vova-tymosh/RCC-Nodes/README.md

# RCC-Nodes

This is the home for various applications of the RCC technology - decoders, throttle and other things. Read more about RCC on the main page - [RCC](https://github.com/vova-tymosh/RCC).

Content is organized in the following folders:
* [Loco](Loco): how to build and use RCC locomotive decoder
* [Throttle](Throttle): how to build and use a handheld RCC controller/throttle (_coming soon_)
* Turnout: _coming soon_
* Test: the set of tests for the RCC components (this folder might be of interest only for the contributors).
