vova-tymosh/RCC-Nodes/Loco/schematic/info.txt

Change log:
    v0.8: Add resistor for LED
    v0.7: Change MAX
    v0.6: Add LED
    v0.5: Add sound, bemf.
          Remove bulk, add GPIOs 
    v0.3: Add bulk capacitor
    v0.2: Fix i2c
    v0.1: Very initial build

Schematic details and considerations:

Capacitors:
    ina219, XIAO, ULN: no caps
    LDO: 1uF on both sides
    DRV: 1+100uF
    MAX: 10+0.1uF
    TCA: Likely 1uF

Voltage rating:
    LDO: 24V
    DRV: 45v
    ULN: 50v
    ina: 26v

I2C Addresses:
    INA: 0x40
    TCA: 0x21 (addr pin is connected to VCC, so the address is 0x21, not 0x20)
