vova-tymosh/RCC-Nodes/Loco/image/decoder_front.png

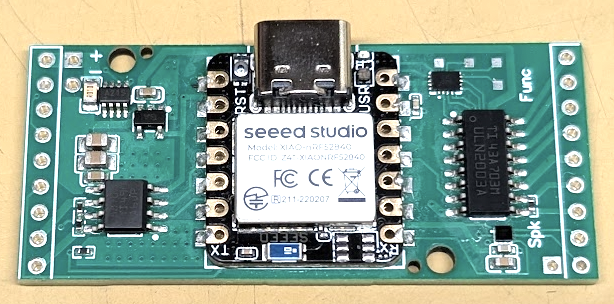
Loco/image/decoder_front.png
