vova-tymosh/RCC-Nodes/Loco/fabrication/BOM_RccDecoder.csv

ID | Name | Designator | Footprint | Quantity | Manufacturer Part | Manufacturer | Supplier | Supplier Part | Price
1 | JFunc | J2 | CONN-9P-SMALL | 1 | KF128-2.54-9P | KEFA(科发) | LCSC | C474927 | 0.921
2 | JMain | J1 | CONN-9P-SMALL | 1 | KF128-2.54-9P | KEFA(科发) | LCSC | C474927 | 0.921
3 | 22uF | C5,C3 | C0805 | 2 | CL21A226MAQNNNE | SAMSUNG(三星) | LCSC | C45783 | 0.021
4 | 1uF | C1,C4 | C0603 | 2 | CL10A105KB8NNNC | SAMSUNG(三星) | LCSC | C15849 | 0.004
5 | 2.2uF | C2 | C0402 | 1 | CL05A225MQ5NSNC | SAMSUNG(三星) | LCSC | C12530 | 0.002
6 | 10uF | C6 | C0402 | 1 | CL05A106MQ5NUNC | SAMSUNG(三星) | LCSC | C15525 | 0.004
7 | 220nF | C7 | C0603 | 1 | CL10B224KA8NNNC | SAMSUNG(三星) | LCSC | C21120 | 0.005
8 | 10mΩ | R1 | R0805 | 1 | RLM10FTBMR010 | 大毅科技 | LCSC | C382280 | 0.049
9 | 4.7kΩ | R2,R4,R5 | R0402 | 3 | 0402WGF4701TCE | UNI-ROYAL(厚声) | LCSC | C25900 | 0.001
10 | 1kΩ | R3 | R0402 | 1 | 0402WGF1001TCE | UNI-ROYAL(厚声) | LCSC | C11702 | 0.001
11 | AP2204K-5.0TRG1(MS) | U2 | SOT-23-5_L3.0-W1.5-P0.95-LS2.8-BL | 1 | AP2204K-5.0TRG1(MS) | MSKSEMI(美森科) | LCSC | C20627186 | 0.111
12 | DRV8870DDAR | U3 | HSOP-8_L5.0-W4.0-P1.27-LS6.2-BL-EP | 1 | DRV8870DDAR | TI(德州仪器) | LCSC | C86590 | 0.28
13 | INA219AIDCNR | U4 | SOT-23-8_L3.0-W1.7-P0.65-LS2.8-BR | 1 | INA219AIDCNR | TI(德州仪器) | LCSC | C87469 | 0.594
14 | TCA6408ARSVR | U5 | UQFN-16_L2.6-W1.8-P0.40-BL | 1 | TCA6408ARSVR | TI(德州仪器) | LCSC | C2649390 | 0.467
15 | ULN2003ADR | U6 | SOIC-16_L9.9-W3.9-P1.27-LS6.0-BL | 1 | ULN2003ADR | TI(德州仪器) | LCSC | C7512 | 0.098
16 | MAX98357AEWL+T | U7 | WLP-9_L1.4-W1.3-P0.40-R3-C3-BR | 1 | MAX98357AEWL+T | ADI(亚德诺)/MAXIM(美信) | LCSC | C2682619 | 0.485
