vova-tymosh/RCC-Nodes/Loco/schematic/Schematic_RccDecoder_v05.pdf

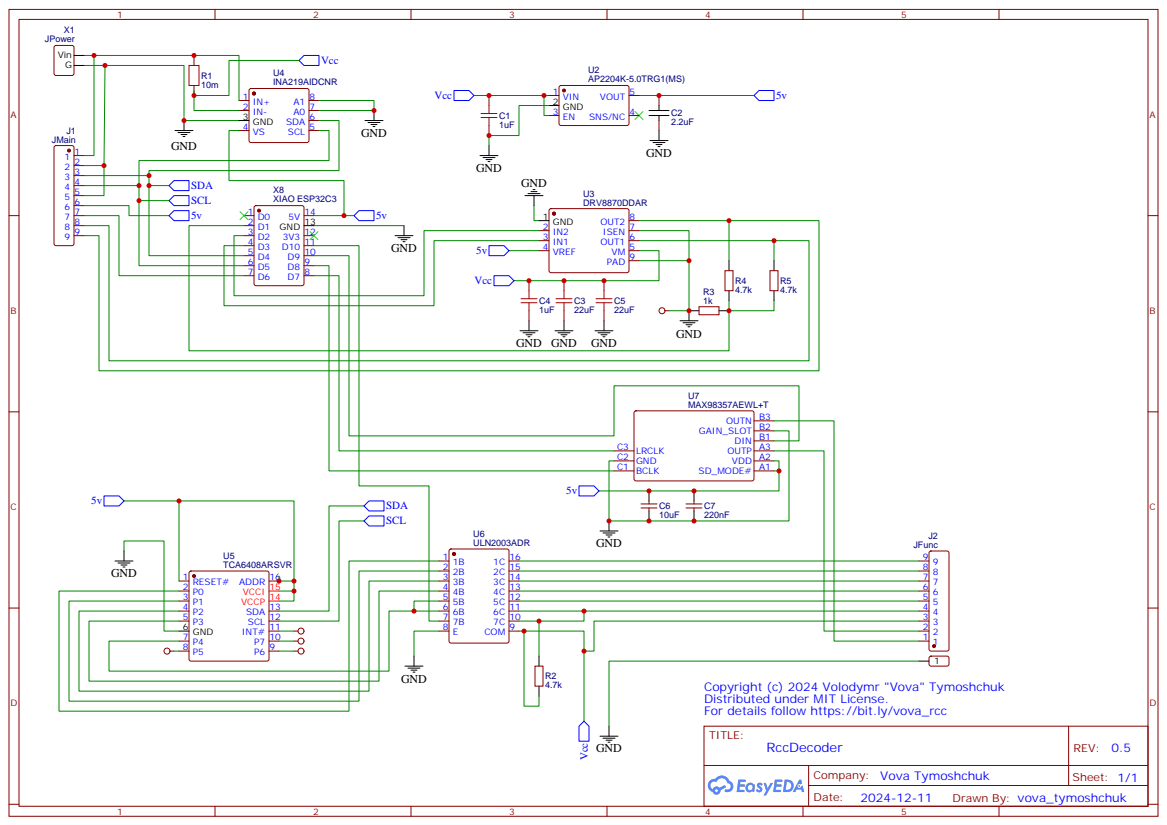
[picture p6: page 1]

TCA6408ARSVR
P7 10 INT# 11 SCL 12 SDA 13 VCCP 14 VCCI 15 ADDR 16

Copyright (c) 2024 Volodymr "Vova" Tymoshchuk
Distributed under MIT License.
For details follow https://bit.ly/vova_rcc
TITLE:
