vova-tymosh/RCC-Nodes/(threads)

Thread 1 (2024-12-05):

Before hw v0.4

vova-tymosh, 2024-12-05:
- [x] 1. Test drv at 1, 2, 3A. Check temperature
- [x] 2. Try 4A and see what will happen
- [x] 3. Test 300-400mA load on 5v
- [x] 4. Run 212 w/o bulk capacitor.
- [x] 5. Including motor stall
- [x] 6. Try 1,2A load with bulk (if it helps)
- [x] 7. If no issues - remove bulk from 0.4

Closed 2025-01-10.

Thread 3 (2025-01-10):

Build test bed

vova-tymosh, 2025-01-10:
- [ ] Build pogo setup
- [ ] Add all HW around pogo
- [ ] Write self-sustaining fully automated test - sanity/smoke test.
- [ ] Add FW flashing
- [ ] Deeper test, semi-auto with LED for motor and things
