vova-tymosh/RCC-Nodes/Throttle/HomeScreen.h

#pragma once

#include "Battery.h"
#include "LocoState.h"
#include "States.h"
#include "Rotary.h"
#include "Timer.h"
#include "UI.h"


extern UserInterface ui;

class HomeScreen : public BaseState
{
    int oldThrottle = 0;
    int rotaryOffset = 0;

private:
    Timer batteryCycle;
    Timer throttleCycle;


    char renderDirection()
    {
        if (pad.state.direction == 0)
            return 'R';
        if (pad.state.direction == 2)
            return '\xEF';
        else
            return 'F';
    }

    void renderBattery()
    {
        static int animation;
        int level = battery.getLevel();
        if (battery.isCharging()) {
            if (batteryCycle.hasFired()) {
                if (animation >= UserInterface::BATTERY_FULL)
                    animation = 0;
                else
                    animation++;
            }
            level = animation;
        }
        ui.showBattery((UserInterface::BatteryState)level);
    }

    void renderDisatnce(char *line, int distance)
    {
        if (distance < 1000) {
            sprintf(line, "%-3d          ", distance);
        } else if (distance < 10000) {
            sprintf(line, "%.2fk         ", (float)distance / 1000);
        } else {
            sprintf(line, "%.1fk         ", (float)distance / 1000);
        }
    }

    void renderTime(char *line)
    {
        unsigned long now = millis();
        now = now - controls.timerBase;
        unsigned long sec = now / 1000;
        unsigned long min = sec / 60;
        sec = sec % 60;
        sprintf(line, "%02d:%02d", min, sec);
    }

    void renderSmall()
    {
        static const char fmt1[] = "Loco:%4s   %3d%%";
        static const char fmt2[] = "T:%-3d R:%-3d S:%-3d D:%c";
        static const char fmt3[] = "%2d%cC    %2dpsi    ";
        static const char fmt4[] = "ODO:                     ";
        char line[ui.width + 1];

        ui.startScreen();
        sprintf(line, fmt1, pad.getSelectedName(), pad.getConnSuccessRate());
        ui.display.println(line);
        sprintf(line, fmt2, controls.throttle, pad.state.throttle, pad.state.speed, renderDirection());
        ui.display.println(line);
        sprintf(line, fmt3, pad.state.temperature, 0xF7, pad.state.psi);
        ui.display.println(line);
        sprintf(line, fmt4);
        renderDisatnce(line + 4, pad.state.distance);
        renderTime(line + 16);
        ui.display.println(line);

        renderBattery();
        ui.display.display();
    }

    void renderBig()
    {
        static const char fmt1[] = "T:%-3d %c%c";
        static const char fmt2[] = "%2d%c %.1fk";
        char line[ui.width + 1];

        ui.startScreen();
        ui.display.setTextSize(2);
        char alive = ' ';//comms.isAlive() ? 0x1F : ' ';
        sprintf(line, fmt1, controls.throttle, renderDirection(), alive);
        ui.display.println(line);
        sprintf(line, fmt2, pad.state.temperature, 0xF7,
                (float)pad.state.distance / 1000);
        ui.display.println(line);

        renderBattery();
        ui.display.setTextSize(1);
        ui.display.display();
    }

public:
    HomeScreen() : batteryCycle(500), throttleCycle(300) {};


    int getRotary()
    {
        int r = rotary.readAccelerated();
        int t = 2 * (r - rotaryOffset);
        if (t > 100) {
            t = 100;
            rotaryOffset = r - t/2;
        } else if (t <= 0) {
            t = 0;
            rotaryOffset = r;
        }
        return t;
    }

    State handle(char key)
    {
        if (key == 'm') {
            return STATE_MENU;
        } else if (key == 's') {
            controls.throttle = 0;
            rotaryOffset = rotary.read();
        } else if (key == ON_ENTER) {
            controls.throttle = pad.state.throttle;
            rotaryOffset = rotary.read() - controls.throttle / 2;
            batteryCycle.start();
            throttleCycle.start();
        } else if (key == 'd') {
            if (controls.direction != 0)
                controls.direction = 0;
            else
                controls.direction = 1;
            pad.setDirection(controls.direction);
            pad.askHeartbeat();
        }

        controls.throttle = getRotary();
        if ((pad.state.throttle != controls.throttle) && throttleCycle.hasFired()) {
            pad.setThrottle(controls.throttle);
            pad.askHeartbeat();
        }

        if (settings.getCachedInt("BigFont"))
            renderBig();
        else
            renderSmall();

        return STATE_NONE;
    }
};
