vova-tymosh/RCC-Nodes/Throttle/MenuScreen.h

#pragma once

#include "States.h"
#include "Storage.h"
#include "UI.h"
#include "Rotary.h"


extern UserInterface ui;
extern Storage storage;

class MenuItem
{
protected:
    const char *name;
    const int index;

public:
    MenuItem(const char *name, const int index) : name(name), index(index) {}
    virtual void setup() {};
    virtual void render(char *line, size_t size) = 0;
    virtual void toggle() = 0;
};

class MenuItemLocoName : public MenuItem
{
public:
    MenuItemLocoName() : MenuItem(NULL, 0) {}

    void render(char *line, size_t size)
    {
        static const char fmt1[] = "Loco             %-4s";
        snprintf(line, size, fmt1, pad.getSelectedName());
    }

    void toggle()
    {
        pad.cycleSelected();
        pad.askHeartbeat();
        pad.getValue("pump");
    }
};

class MenuItemFunction : public MenuItem
{
public:
    MenuItemFunction(const char *name, const int index)
        : MenuItem(name, index) {}

    void render(char *line, size_t size)
    {
        static const char fmt1[] = "%-18s%s";
        if (pad.state.bitstate & (1 << index))
            snprintf(line, size, fmt1, name, "ON");
        else
            snprintf(line, size, fmt1, name, "OFF");
    }

    void toggle()
    {
        int state = (pad.state.bitstate & (1 << index)) ? 0 : 1;
        pad.setFunction(index, state);
        pad.askHeartbeat();
    }
};

class MenuItemPump : public MenuItem
{
public:
    MenuItemPump() : MenuItem("pump", 0) {}

    void render(char *line, size_t size)
    {
        snprintf(line, size, "Pump              %d", controls.pump);
    }

    void toggle()
    {
        if (controls.pump < 100)
            controls.pump += 10;
        else
            controls.pump = 0;
        pad.setValue("pump", String(controls.pump).c_str());
    }
};


class MenuItemSetting : public MenuItem
{
    int savedState;

public:
    MenuItemSetting(const char *name)
        : MenuItem(name, 0)
    {
    }

    void render(char *line, size_t size)
    {
        static const char fmt1[] = "%-18s%s";
        if (settings.getCachedInt(name))
            snprintf(line, size, fmt1, name, "ON");
        else
            snprintf(line, size, fmt1, name, "OFF");
    }

    void toggle()
    {
        int c = settings.getCachedInt(name);
        settings.put(name, String(c ? 0 : 1));
    }
};

class MenuItemLocal : public MenuItem
{
    int saved;
    const char* settingName = "locoaddr";
    const int node = 1;

public:
    MenuItemLocal()
        : MenuItem("", 0) {}

    void setup()
    {
        saved = settings.getCachedInt(settingName);
    }

    void render(char *line, size_t size)
    {
        int c = settings.getCachedInt(settingName);
        if (c != saved)
            snprintf(line, size, "Local(bootme)     %s", c ? "OFF" : "ON");
        else
            snprintf(line, size, "Local             %s", c ? "OFF" : "ON");
    }

    void toggle()
    {
        int c = settings.getCachedInt(settingName);
        settings.put(settingName, String(c ? 0 : node));
    }
};



auto mi0 = MenuItemLocoName();
auto mi1 = MenuItemFunction("Lights", 0);
auto mi2 = MenuItemFunction("Bell", 1);
auto mi3 = MenuItemFunction("Slow", 28);
auto mi4 = MenuItemFunction("Pid", 29);
auto mi5 = MenuItemPump();
auto mi6 = MenuItemSetting("BigFont");
auto mi7 = MenuItemLocal();
MenuItem *menuItem[] = {&mi0, &mi1, &mi2, &mi3, &mi4, &mi5, &mi6, &mi7};

class MenuScreen : public BaseState
{
    static const int LINES = 4;
    static const int menuSize = sizeof(menuItem) / sizeof(menuItem[0]);
    int selected = 0;
    int rotaryOffset = 0;
public:
    void setup()
    {
        for (int i = 0; i < sizeof(menuItem) / sizeof(menuItem[0]); i++)
            menuItem[i]->setup();
    }

    State handle(char key)
    {
        if (key == 'h') {
            return STATE_HOME;
        } else if (key == ON_ENTER) {
            pad.getValue("pump");
            selected = 0;
            rotaryOffset = rotary.read();
        } else if (key == 'm') {
            menuItem[selected]->toggle();
        }

        selected = (rotaryOffset - rotary.read()) % menuSize;
        if (selected < 0)
            selected = menuSize + selected;
        else if (selected >= menuSize)
            selected = menuSize - 1;

        int base = 0;
        if (selected >= LINES)
            base = selected - LINES + 1;
        ui.startScreen();
        for (int i = base; i < base + LINES; i++) {
            char line[ui.width + 1];
            ui.textColor(selected == i);
            menuItem[i]->render(line, sizeof(line));
            ui.display.println(line);
        }
        ui.display.display();
        return STATE_NONE;
    }
};
