vova-tymosh/RCC-Nodes/(commit log)

2024-04-17 New protocol for Throttle support
    - Rename Controller to Throttle (as per JMRI standard)
    - Define new Auth for Loco/Thr
    - Add todos for Throttle code
    - Throttle auth/subsription still missing list of locos
    [HomeScreen.h, LocoState.h, MenuScreen.h, Rotary.h, Throttle.ino, UI.h]
2024-04-28 Throttle <> Loco comunication
    - Change protocol to fixed for all Locos
    - Move light to functions
    - Make functions start with lights and with code '@'
    - Store all the functions as bitstate
    - Update RRLib test to emmit all new fields
    - Chnage Loco status messages to send u16 instead of floats
    - Forward data from Throttle to Loco via push
    - Remove slow forwarding (for now)
    - Handle battery presentation (1-3 from %%)
    - Handle lights in menu and throttle by the rotary
    - Add retries to the send function on Throttle side
    [HomeScreen.h, LocoState.h, MenuScreen.h, Rotary.h, Throttle.ino]
2024-04-30 Further improvements
    - Change direction to 2 bits
    - Change direction to 0,1,2 instead of 0,1,-1
    - Handle stop on RRlib side
    - Mimic speed with Slow and Stop
    - Use received state for Menu items
    - Queue up Thr messages and resend couple times
    - Add inbound/outbound lost (temporarily)
2024-04-30 Conn improvements
    - Reduce Station power to LOW
    - Remove all Thr queue code, just resend last command every 100ms
2024-05-01 Screensaver and small fixes
    - Add Screen Svaer (turn off screen after timeout)
    - Replace loco to extern for HomeScreen
    - Restructure Lost for ThrComms
    - Add Thr lost to Loco lost on Home screen
    [HomeScreen.h, LocoState.h, MenuScreen.h, Throttle.ino, UI.h]
2024-05-01 Proper states and scrolling in menu
    - Replace ugle state functions with nice objects
    - Add more than 4 items in menu with scrolling
    [HomeScreen.h, MenuScreen.h, States.h, Throttle.ino]
2024-05-01 Fix rotary & other minor things
    - Move Rotary to another input (the board needs to be replaced)
    - Add water field
    - Add T/R on Home
    - Minor fixes
    [HomeScreen.h, LocoState.h, Rotary.h, Throttle.ino]
2024-05-01 Fixes in lost calculation
    [HomeScreen.h]
2024-05-01 Add Thr battery
    - Read voltage & charging
    - Show level & charging process
2024-05-01 Add Loco battery as "B:", rearrange Home
2024-05-05 Local mode
    - Send all new reg to Thr when new Loco registers
    - Add Settings (starting with local mode)
    - Add FS to save/restore Settings
    - Menu item for Local
    - Fix cycling through locos in both Local/Remote modes
    - ThrComm support for Local
    [LocoState.h, MenuScreen.h, Throttle.ino]
2024-05-14 Updated 948 to the new wireless protocol and couple fixes
    - Remove outdated code
    - Move motor control to seperate file
    - Spinn off Led to a RRlib class
    - Push Storage into a class, handle save/restore inside Comms
    - Add constrain to Comms throttle and direction
    - Reaplce Speed Sensor with 1204 implementation
    - Update Thr keypad per the latest schematic
    [Rotary.h, Throttle.ino]
2024-05-15 Fixes
    - Restore watchdog for 948
    - Fix 'd' key (should do 'stop' only on Home)
    - Fix Thr screensaver
    [HomeScreen.h, Throttle.ino]
2024-06-06 Throttle updates - LocoState and Rotary period
    - Share LocoState strcut between Loco and Throttle
    - Update Rotary more often to smooth live steam servo
2024-06-11 Set of fixes after steaming test
    - Add temprerature sensor back to 002
    - Make both 002 and 1204 temperature sensors for now, todo - clean up and combine
    - Change RCCState, reduce some fileds to 8bit, incread distance and tick to 32b
    - Update Station code to deal with new firmat of RCCState
    - Revert speed sensor to use floats instead of doubles
    - Flash 'neutral' on the Throttle screen (so it is clear why loco doesn't move)
    - Add XX.Xk for distance on Throttle screen
    - Clen up 'big font' screen
    - Reset timer by key '3'
    - Change screen saver to 3 mins (from 1)
    [HomeScreen.h, LocoState.h, Throttle.ino]
2024-06-13 Protocol format and version
    - Clean up 1204 temp sensor naming
    - Add 1204 temp/pressure on tender side
    - Send LocoState version and python stuct format with reg packet
    - Update the station to handle this
    - Update the throttle to do the same
2024-09-26 Split 948 into Loco/Tender
    - Add intercom
    - Add speed sensor
    - Rear lights are not integrated yet
2024-09-29 Throttle fixes
    - Battery chanrging while without locos
    - Starting F
    - Loco.distance
    [HomeScreen.h, Throttle.ino]
2024-11-05 Added DCC support. First working draft
    - Modify Tender of 948 for DCC
    - Add DCC lib
    - Add Serial input to control DCC
    - Modify Tender948 to translate RCC to DCC
    - Remove Intercom, symplify HW to one MCU, use 4 wires from Tender to control motor and HL
    - Move protocol specific constants to RCCState
    - Expand functions to 32b (to support up to 30 functions)
    - Add tons of sound fucntions to RCCState::bitsate
    - Update Throttle to new protocol, add couple functions to hot keys
    - TODO: Reduce DCC to minimum
    - TODO: Fix storage 16/32bit for NRF52
    - TODO: Fix DCC conn lost after F23
    [MenuScreen.h, Throttle.ino]
2024-11-19 Update style and format across RRLib and Locos
    - Move code formatting to the root
    - Update format across Loco and RRlib folders
    - Rename all vars to lower_case, keeping functions arduinoStyle
2024-11-19 Fix style for Throttle, couple minor things
    - Fix style and naming
    - Add vscode to gitignore
    - Close dcc phy code under no-NRF define (need a proper fix)
    [Battery.h, HomeScreen.h, LocoState.h, MenuScreen.h, Rotary.h, States.h, Throttle.ino, UI.h]
2024-11-24 First working version of test
    - Add rccTest - super siple test framework for over-serial comms
    - Add Cli.h - a super simple serial command parser
    - Use Cli in TestLoco
2024-11-24 Add power meter support (draft)
    - Add INA219
    - Fix pcb (cut SDA link to Functions)
    - Add example code of power measurement and printing (to remove in final version)
2024-11-26 Fix motor driver
    - Fix the driver - use "break" instead of "cost"
    - Add BEMF reading (needs tuning)
    - Simplify CLI commands a little
2024-12-01 Push moror/powerMetter out, add tests
    - Add PowerMeter test cases
    - Add radio under a test case
2024-12-23 Add fabrication files
    [BOM_RccDecoder_v05.csv, PickAndPlace_RccDecoder_v05.csv]
2024-12-23 Cleaning up PCBA stuff
    [CPL_RccDecoder_v05.csv]
2024-12-24 Add schematic
2025-01-02 Chnage test loco to new Pin classes
2025-02-04 Update Throttle to newer arch, fix direction
    - Update Throttle code to RCC latest
    - Change direction from 0-1-2 to 0-1 (as per DCC and WiThrottle)
    [HomeScreen.h, MenuScreen.h, Throttle.ino]
2025-02-20 Remove version from the fabrication file names
    [BOM_RccDecoder.csv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]
2025-05-07 Start of protocol redesign for Throttle
    [HomeScreen.h, LocoState.h, MenuScreen.h, Throttle.ino]
2025-05-07 Update to the latest RCC, celan up and fix
    [HomeScreen.h, MenuScreen.h, Throttle.ino]
2025-05-20 Fix Throttle with new RCC
    - Replace Keypad with Pad
    - Update local Settings to the new arch
    - Updtae/simplify toggle menues
    [HomeScreen.h, LocoState.h, MenuScreen.h, Rotary.h, Throttle.ino]
2025-05-22 Fix Throttle rotary, add pump, simplify menu
    - Fir the rotary (align times of disaply & rotary)
    - Add pump to Throttle
    - Simplify menu classes
    [Battery.h, LocoState.h, MenuScreen.h, Rotary.h, Throttle.ino]
2025-06-21 Switch to 360 encoder
    - Move away from e2e potentiometer
    - Add spining wheel support (rotary encoder)
    - Move throttle update to Home state
    - Add manu navigation with rotary
    - Add ON_ENTER for states
2025-06-22 Rotary acceleration
    - Better handling of throttle with rotary
2025-09-19 Add/fix Loco switch
    - Update Home with current loco Throttle
    - Speed up throttle change/delivery
    [HomeScreen.h, LocoState.h, MenuScreen.h, Throttle.ino]
2025-09-24 Improve throttle handling
    - Add timer to slow down spam or throttle/getHB commands
    - Remove loco cycle hot key
    - Add a little around stop command (still not broadcasting)
